aprsworld/dcswc_module_latching_contactor/hardware/dcswc_module_latching_contactor_rev4.pdf

## ICSP_PGD

## ICSP_PGC

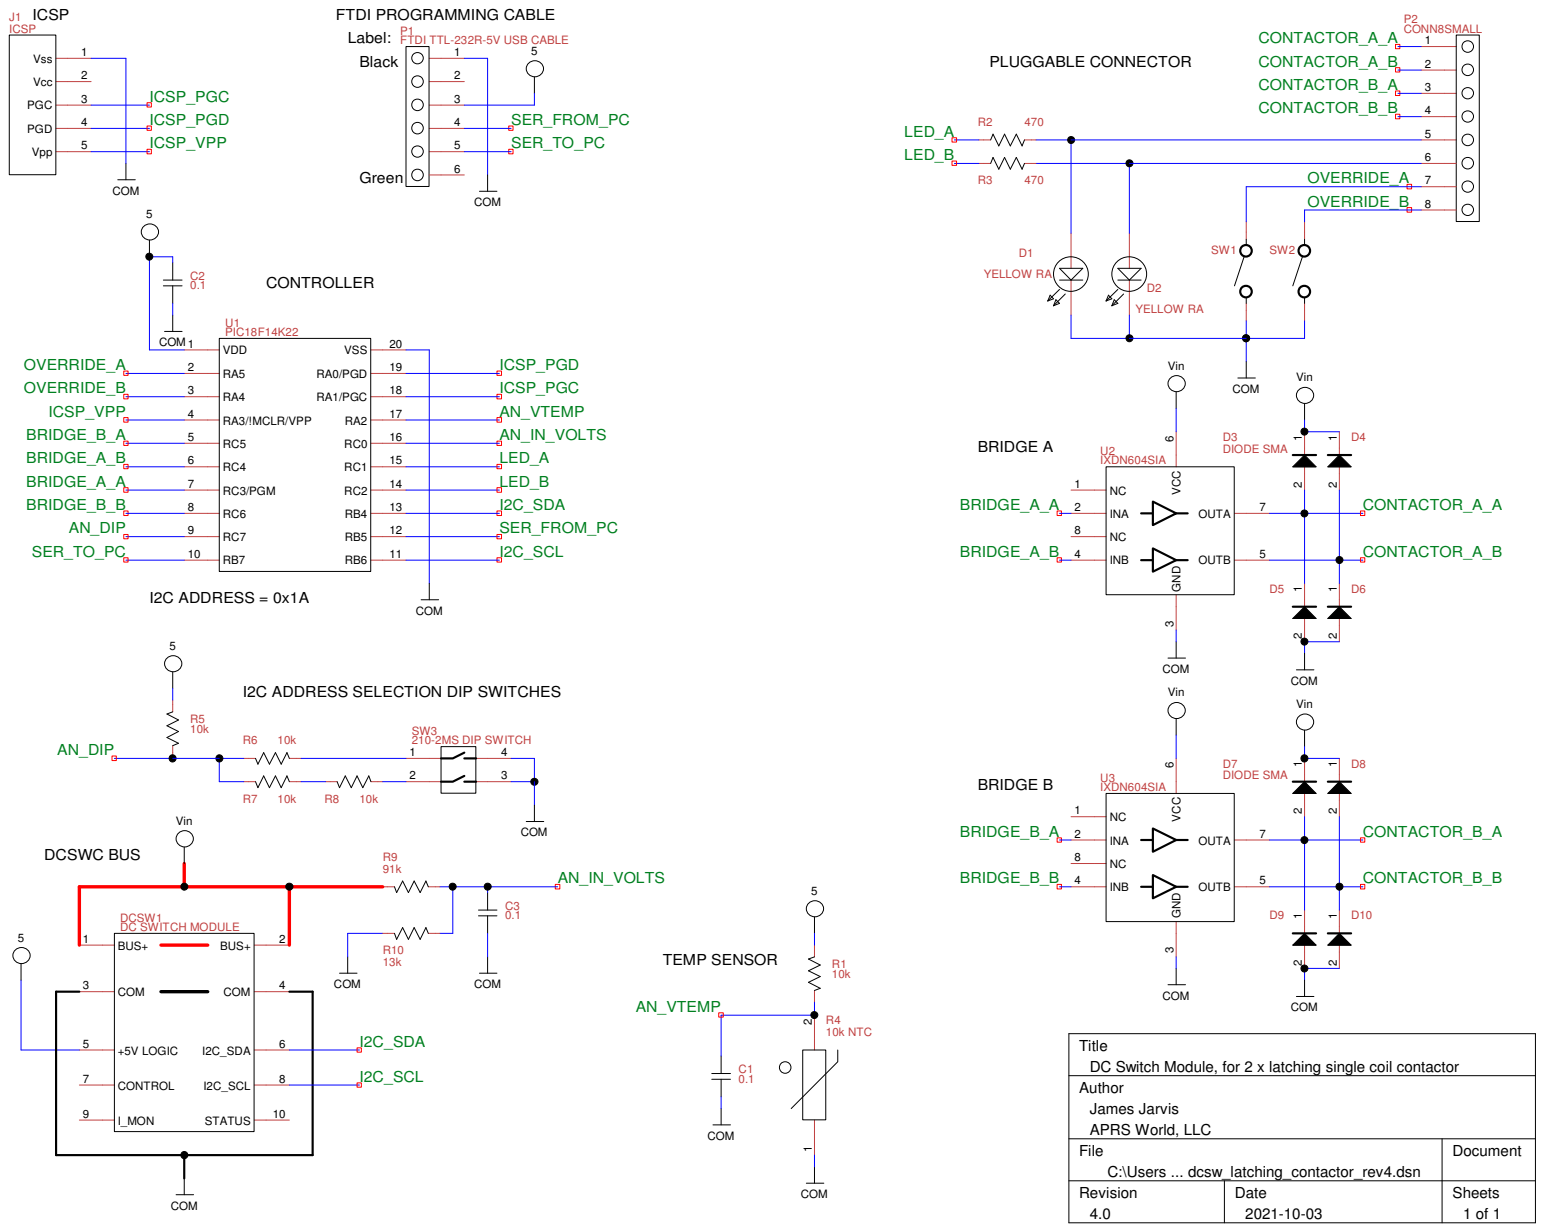
[picture p1: page 1]

I2C ADDRESS SELECTION DIP SWITCHES

Title
DC Switch Module, for 2 x latching single coil contactor
Author
James Jarvis
APRS World, LLC

File C:\Users ... dcsw_latching_contactor_rev4.dsn | Document

Revision 4.0 | Date 2021-10-03 | Sheets 1 of 1
