aprsworld/dcswc_module_latching_contactor/(threads)

Thread 1 (2022-01-06):

update I2C slave ISR to good version from pzPowerI2C

kb0thn, 2022-01-06:

kb0thn, 2022-01-14:
actually we want to get it from:
https://github.com/aprsworld/dcswc_module_voltage_current_counter/blob/main/interrupt_dcswc_module_voltage_current_counter.c

kb0thn, 2022-02-05:
Updated to voltage current counter code, but needs to be tested

kb0thn, 2023-11-04:
tested over last year and a half

Closed 2023-11-04.

Thread 2 (2022-01-14):

implement and test WTD, brownout, etc

kb0thn, 2022-01-14:
dcswc_module_voltage_current_counter has working WDT on the same processor

kb0thn, 2022-02-07:
appears to be working. But discovered MPLAB / CCS are overriding my desired fuses. Need to copy note and fuses from this project to pzPowerI2C and dcswc_module_voltage_current_counter and anything else using a 14K22.

Closed 2022-02-07.
