aprsworld/dcswc_module_latching_contactor/(commit log)

2022-02-05 Added schematic
2022-02-05 setting up I2C access
2022-02-06 LVD seems to be working at least. And override switch
2022-02-06 Working on getting LEDs blinking
2022-02-06 LEDS status blinks work nicely now
2022-02-06 LTD working. LEDs are still a bit wonky
2022-02-07 fuses work, appears to be happy!
2023-11-04 Updated I2C configuration register addresses
2023-11-05 Fixed I2C register writing problem
    [dcswc_module_latching_contactor.c, debug_dcswc_module_latching_contactor.c, i2c_handler_dcswc_module_latching_contactor.c, param_dcswc_module_latching_contactor.c]
